MostlyKIGuess/Theremin-Circuit/Report/main.pdf

# Modernizing the Theremin: A Portable Circuit with Single-Antenna and Manual Volume Knob

Krish Pandya
2023102026
IIIT Hyderabad
krish.pandya@students.iiit.ac.in

Vaibhav Wadhwani
2023102058
IIIT Hyderabad
vaibhav.wadhwani@students.iiit.ac.in

Abstract—This report details the design, simulation, and testing of a modernized portable Theremin, an electronic musical instrument played without physical contact. Unlike traditional Theremins, our design features a single antenna for pitch control and a manual potentiometer for volume adjustment, making it more compact and accessible. The circuit utilizes capacitive sensing via the antenna to control the pitch of the output sound, with the core principle involving heterodyning signals from a Variable Frequency Oscillator (VFO) and a Fixed Frequency Oscillator (FFO). The resulting difference frequency, falling within the audible range, is then filtered, amplified, and output through a power amplifier stage. The design primarily uses operational amplifiers for oscillation, mixing, filtering, and preamplification, with a Class AB BJT stage for power amplification. Operating on a ±5V dual power supply derived from batteries, the circuit is completely portable and ready for use in various performance settings.

I. INTRODUCTION

The Theremin, invented by Leon Theremin around 1920, ´ stands as one of the earliest electronic musical instruments and is unique for being played without physical contact. It typically features two antennas: one controlling pitch and the other controlling volume, based on the proximity of the player’s hands [1]. The instrument operates on the principle of heterodyning, where two high-frequency radio signals are mixed together. The difference between these two frequencies results in a beat frequency within the audible range (20 Hz to 20 kHz). Traditional Theremins typically feature two antennas: one controlling pitch and the other controlling volume, based on the proximity of the player’s hands. Our modernized approach simplifies this design by using a single antenna for pitch control and incorporating a manual potentiometer for volume adjustment, making the instrument more portable and user-friendly.
The use of heterodyning is advantageous because LC oscillators, commonly used in such circuits, exhibit greater stability and precision at higher frequencies (hundreds of kHz to MHz range). Generating stable audio-frequency tones directly using simple LC circuits can be challenging and less accurate. By generating two higher frequencies—one fixed (FFO) and one variable (VFO) controlled by hand capacitance—and then mixing them, a precisely controllable audio frequency (fV F O − fF F O) can be obtained. The player’s hand acts as the grounded plate of a variable capacitor relative to the pitch antenna, altering the capacitance in the VFO circuit and thus changing its frequency.
This project focuses on the design, simulation, and implementation of a portable Theremin circuit using readily available components like operational amplifiers (Op-Amps) and bipolar junction transistors (BJTs). While traditional Theremins use a second antenna for volume control, this design employs a potentiometer for manual volume adjustment.

II. WORKING PRINCIPLE
The operation of the designed Theremin circuit relies on several key principles:
- Capacitive Sensing: The player’s hand acts as a variable capacitor when brought near the pitch antenna. This change in capacitance modifies the frequency of the Variable Frequency Oscillator (VFO).
- Oscillation: Two oscillators are used:
– Variable Frequency Oscillator (VFO): Its frequency changes based on the hand’s proximity to the pitch antenna.
– Fixed Frequency Oscillator (FFO): Generates a stable reference frequency close to the VFO’s operating range.
- Heterodyning (Mixing): The signals from the VFO and FFO are combined using a mixer circuit (summing amplifier). The output of the mixer contains sum (fV F O+ fF F O) and difference (|fV F O − fF F O|) frequencies.
- Filtering: Active filters (low-pass and high-pass) are employed to isolate the difference frequency, which constitutes the audible tone, and remove unwanted DC offsets and high-frequency components.
- Amplification and Volume Control: The filtered audio signal is amplified. A potentiometer is integrated to allow manual control over the final output volume before the signal is sent to the power amplifier.
- Power Amplification: A Class AB power amplifier stage provides sufficient current gain to drive a low-impedance load, such as a speaker.

III. CIRCUIT OVERVIEW
The complete Theremin circuit designed and simulated in LTSpice is shown in Fig. 1. It integrates several functional blocks: the VFO, FFO, Mixer, Filters, Pre-Amplifier/Volume

Control, Sound Amplifier, and Power Amplifier. Operational amplifiers (OP27, UA741, OP37) are utilized for most signal generation and processing stages. The circuit is powered by a ±5V dual rail supply, typically derived from batteries using voltage regulators ( Note: We used give power supply, also tested using batteries , so it is completely portable and ready to use). Fig. 2 shows a representation related to the physical implementation.
We have written almost all the formulas that we used in circuit, for further derivations and calculations, please refer to the slides ( Available on Github ) [5] . The circuit is designed to be compact and efficient, with careful consideration of component values to achieve the desired frequency response and gain characteristics. (Note: In the report the numbers you see with R and C, they can be cross-referenced with the circuit diagram, and these values can be seen in the circuit diagram 1, that can also be found on github as it’s LTSpice file as well as images).


Fig. 1: Simulated Theremin Circuit Schematic (LTSpice)

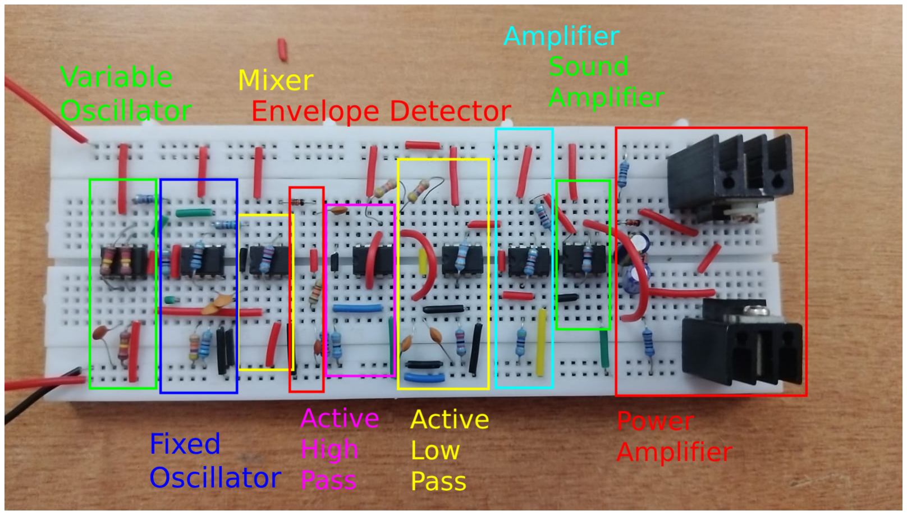
[picture p8: figure]

Fig. | 2: | Theremin | Circuit | Schematic | (Physical
Layout/Simplified)

IV. OSCILLATOR STAGES
A. Variable Frequency Oscillator (VFO)
The VFO generates a signal whose frequency is sensitive to the capacitance of the pitch antenna, which varies with hand proximity.
- Topology: An Op-Amp based relaxation oscillator using U1 (OP27) was chosen [2].
- Key Components: U1 (OP27), R1, R2, R3 (100 kΩ), C1 (100 pF), Antenna (modeled as 23 pF base capacitance + variable hand capacitance Chand) (Note: This can vary , ours was a copper wire around 600cm coiled up , so it came around this from frequency calculation.).
- Operation: The total capacitance (Ctotal = Cbase + Chand) at the oscillator’s timing node determines its frequency. As the hand approaches the antenna, Chand increases, increasing Ctotal and thus decreasing the VFO frequency fV F O. Due to heterodyning, a decrease in fV F O leads to an increase in the difference frequency (|fV F O − fF F O|), resulting in a higher audible pitch.
- Frequency Calculation: The approximate frequency of the relaxation oscillator is given by:

fV F O ≈

1
2RCtotal ln
1+k
1−k
| (1)

where R involves resistors like R3, Ctotal is the total capacitance including the antenna and C1 (specific calculation depends on exact topology implementation, e.g., R=120k, C=175p from slides gives 21.9kHz), and k =

R2
R1+R2

. With R1=R2=100 kΩ, k = 0.5, and ln( ¹⁺⁰.5
1−0.5

) = ln(3) ≈ 1.1. The exact values used in the physical circuit (R = 120k, C = 175p - base capacitance) give a slightly different calculated base frequency around 21.92 kHz.

The output waveform of the implemented variable oscillator is shown in Fig. 3.


Fig. 3: Variable Oscillator Output Waveform (Physical Measurement)

B. Fixed Frequency Oscillator (FFO)

The FFO provides a stable reference frequency against which the VFO is compared.

- Topology: A Wien Bridge Oscillator using U7 (UA741 Op-Amp).
- Key Components: U7 (UA741), R18=6.3 kΩ, C4=1 nF, R19=6.3 kΩ, C6=1 nF (frequency network); R16=47 kΩ, R17=100 kΩ (gain network).
- Operation: | The | Wien | Bridge | network | provides
frequency-selective positive feedback. Oscillation occurs at the frequency where the phase shift is zero and the loop gain is unity.
- Frequency Calculation: The oscillation frequency is determined by:
fF F O = | 1
2πRC =
| | | 1
2π(6.8 kΩ)(1 nF) ≈ 23.26 kHz (2)

The required gain for oscillation is Av = 1+R17/R16 = 1 + 100k/47k ≈ 3.13. The gain provided by the circuit is 1 + R17/R16 = 1 + 100k/47k ≈ 3.13 ensuring oscillation starts.

The output waveform of the implemented fixed oscillator is shown in Fig. 4.


Fig. 4: Fixed Oscillator Output Waveform (Physical Measurement)

V. SIGNAL PROCESSING STAGES
A. Mixer (Summing Amplifier)

The mixer combines the VFO and FFO signals to generate the sum and difference frequencies.
- Topology: An inverting summing amplifier using U2 (OP27).
- Key Components: U2 (OP27), Input Resistors R4=47 kΩ (from VFO), R5=47 kΩ (from FFO), Feedback Resistor R6=20 kΩ.
- Operation: The output voltage is the inverted sum of the input voltages, scaled by the ratio of feedback to input resistance.
- Gain Calculation: The gain for each input is:

G = −

Rf

Rin

= −

20 kΩ
47 kΩ ≈ −0.426 | (3)
- Output Voltage:

Vout,mixer = G×(VV F O+VF F O) = −0.426(VV F O+VF F O)
| (4)
This output contains components at frequencies fV F O, fF F O, fV F O + fF F O, and |fV F O − fF F O|.
B. Envelope Detector

An envelope detector stage is included after the mixer. In traditional Theremins, envelope detection might relate to volume control coming from the second antenna. However, in our design, it is used to demodulate the mixed signal.
- Components: Diode D (1N4148), R7 (10 kΩ), C2 (47 nF).
- Function: Performs half-wave rectification (via Diode D) followed by RC low-pass filtering (R7, C2) to extract the signal envelope [3]. This stage seems intended to demodulate the mixed signal to some extent, although its placement after the summing mixer is unconventional for isolating the beat frequency directly.
- Time Constant: τ = R7 × C2 = (10 kΩ)(47 nF) = 0.47 ms.
- Cutoff Frequency: The RC filter has a cutoff frequency fc =

1
2πτ ≈

1
2π(0.47 ms) ≈ 339 Hz. This low cutoff will primarily passes the lower frequency components, including the beat frequency, while smoothing the waveform. ( Note: Explained more in the youtube video [4] )
The output after the envelope detector stage is shown in Fig. 5.
C. Active Filtering Stages

Subsequent filtering stages refine the audio signal.
1) Active High-Pass Filter (HPF): This filter removes any DC offset introduced by previous stages (like the envelope detector) and very low frequencies.
- Topology: First-order active HPF using U3 (OP27) configured as a buffer.
- Components: U3 (OP27), C5 (4.7 nF), R13 (1.7 MΩ).


Fig. 5: Envelope Detector Output Waveform (Physical Measurement)

- Cutoff Frequency:

fc,HP F =

1
2πR13C5

=

1
2π(1.7 MΩ)(4.7 nF) ≈ 19.9 Hz

(5)
This cutoff is appropriate for passing the audible range while blocking DC.

The output after the high-pass filter stage is shown in Fig. 6.
2) Active Low-Pass Filter (LPF): This filter removes high-frequency components remaining after mixing and envelope detection, such as sums of frequencies or oscillator harmonics, leaving primarily the desired difference frequency.
- Topology: Second-order active LPF using U5 (OP27), likely a Sallen-Key or Multiple Feedback topology providing gain. Based on components R10, R11, R12, C3, R23, C9, it resembles a design with feedback providing amplification.
- Components: U5 (OP27), R10=6.3 kΩ, C3=10 nF,
R23=6.3 kΩ, | C9=10 nF | (frequency | determining);
R11=40 kΩ, R12=20 kΩ (gain setting).
- Cutoff Frequency Estimation: For a Sallen-Key LPF with equal R (R10=R23) and C (C3=C9), fc =
| | | 1 2πRC .
Using R=6.3 kΩ and C=10 nF:

fc,LP F =

1
2π(6.3 kΩ)(10 nF) ≈ 2.53 kHz (6)
- DC Gain: The gain appears set by R11 and R12 in a non-inverting configuration related to the feedback:

GDC = 1 +

R11
R12

= 1 +

40 kΩ
20 kΩ = 3 | (7)


Fig. 6: High-Pass Filter Output Waveform (Physical Measurement)

This stage both filters and amplifies the audio signal.

VI. AMPLIFICATION STAGES

A. Pre-Amplifier / Volume Control

This stage provides further voltage gain and incorporates the user volume control.
- Topology: Non-inverting amplifier using U6 (OP27) with gain adjusted by potentiometer U9.
- Components: U6 (OP27), R14 (20 kΩ), R15 (5 kΩ), U9 (Potentiometer, 10 kΩ).
- Gain Range: The voltage gain Av varies with the potentiometer setting (RU9 represents the resistance from the wiper to ground):

Av = 1 +

R14
R15 + RU9

(8)

– Minimum Gain (RU9 = 10 kΩ): Av = 1 + 20
5+10 =
1 + 20
15 ≈ 2.33
– Maximum Gain (RU9 = 0 kΩ): Av = 1 + 20
5+0 =
1 + 4 = 5
B. Sound Amplifier

An additional amplifier stage boosts the signal level before the power amplifier.
- Topology: Inverting amplifier configuration using U4 (OP37).
- Components: U4 (OP37), R8 (10 kΩ), R9 (40 kΩ).
- Gain:
G = −

R9
R8

= −

40 kΩ
10 kΩ = −4 | (9)

This stage inverts the signal while providing a gain of 4.

VII. POWER AMPLIFIER STAGE

The final stage provides the necessary current to drive a low-impedance load like a speaker.
- Topology: Class AB Push-Pull output stage using complementary BJT pair.
- Key Components: Q1 (TIP31C NPN BJT), Q2 (TIP32C PNP BJT), D1, D2 (1N4148 diodes for bias), R20, R21 (1 kΩ base resistors), C7, C8 (1 µF bypass capacitors), R22 (10 Ω load resistor).
- Operation: Q1 amplifies the positive half-cycles of the input signal, while Q2 amplifies the negative half-cycles. Diodes D1 and D2 provide a small forward bias voltage between the bases of Q1 and Q2 to minimize crossover distortion, ensuring a smoother transition between the transistors conducting. This stage primarily provides current gain (power gain) with approximately unity voltage gain.

VIII. POWER SUPPLY

The circuit requires a stable dual-rail power supply for the operational amplifiers and other stages.
- Requirement: ± 5 V DC.
- Implementation: Typically achieved using two 9V batteries connected in series with the center tap serving as ground. Voltage regulators LM7805 (for +5V) and LM7905 (for -5V) are used to provide stable regulated voltages from the batteries.
- Consumption: The Op-Amps consume relatively low quiescent current. The power amplifier stage draws more current depending on the output volume and load. The total power consumption is estimated to be under 3W under normal operation.

IX. OPERATION AND RESULTS

The integrated Theremin circuit functions as follows: The player’s hand proximity to the antenna (modeled by CAntenna) controls the frequency of the VFO (U1). This signal is mixed (U2) with the stable frequency from the FFO (U7). The resulting mixed signal undergoes envelope detection (D, R7, C2) and active filtering (U3, U5) to isolate and clean up the audible difference frequency (|fV F O − fF F O|). This audio signal is then amplified (U6, U4), with volume controlled by the potentiometer (U9), and finally fed to the Class AB power amplifier (Q1, Q2) to drive the speaker (R22).
Physical measurements (Fig. 3, 4, 5, 6) confirm the operation of individual stages, showing the expected waveforms at the outputs of the oscillators, envelope detector, and high-pass filter. The variable oscillator frequency changes as intended with capacitance, and the fixed oscillator provides a stable reference. The filtering stages shape the signal towards the final audio output. The overall result is an audible tone whose pitch changes with hand movement near the antenna and whose volume is adjustable via the potentiometer.
X. PROJECT DEMONSTRATION
A video demonstration showcasing the operation of the constructed Theremin circuit is available online [4]. The video explains the working principles, shows the physical circuit build, and demonstrates the pitch control via hand proximity to the antenna and volume control using the potentiometer.

XI. CONCLUSION
This project successfully demonstrated the design, simulation, and testing of an electronic Theremin circuit based on operational amplifiers and a BJT Class AB output stage. The design employs the principle of heterodyning by mixing signals from a hand-capacitance controlled Variable Frequency Oscillator and a Fixed Frequency Oscillator (Wien Bridge type). The resulting difference frequency is extracted using an envelope detector and active filtering stages (high-pass and low-pass) to produce an audible tone within the range of approximately 20 Hz to 2.5 kHz (based on filter cutoffs). Volume control is implemented manually via a potentiometer integrated into a pre-amplifier stage. A final Class AB power amplifier provides sufficient power to drive a standard 10 Ω speaker load. The circuit operates from a standard ±5 V regulated dual power supply. The design choices, particularly the use of an envelope detector post-mixing and potentiometerbased volume control, differ from some traditional Theremin architectures but provide a functional implementation of the core concept. The simulation and physical measurements validate the operation of the individual stages and the overall system.

REFERENCES

[1] Wikipedia contributors, ”Theremin,” Wikipedia, The Free Encyclopedia, https://en.wikipedia.org/wiki/Theremin .
[2] Circuit | Digest, | ”Relaxation | Oscillator | using | Op-Amp,”
https://circuitdigest.com/tutorial/relaxation-oscillator-using-op-amp
[3] C. Rose, ”Envelope Detector,” Rutgers WINLAB, https://www.winlab.rutgers.edu/∼crose/322 html/envelope detector.html (https://www.winlab.rutgers.edu/~crose/322_html/envelope_detector.html) .
[4] K. Pandya and V. Wadhwani, ”Theremin Project Explanation and Demo,” YouTube, May 5, 2025. [Online]. Available: https://youtu.be/XMQbpG15ijk?si=fTLJ23zKhtOCA8q9 (https://youtu.be/XMQbpG15ijk?si=fTLJ23zKhtOCA8q9)
[5] K. Pandya and V. Wadhwani, ”Theremin Project GitHub Repository,” https://github.com/MostlyKIGuess/theremin-circuit .
