MostlyKIGuess/Theremin-Circuit/proposal/main.pdf

# EW-2 Project 2 Proposal Theremin

### Krish Pandya krish.pandya@students.iiit.ac.in

2023102026

### Vaibhav Wadhwani vaibhav.wadhwani@students.iiit.ac.in

2023102058

### 4th February 2025

## 1 Project Proposal

This project proposes the design and construction of a modern Theremin, a touchless electronic musical instrument that merges classic analog circuitry with contemporary design techniques. The instrument will convert subtle human gestures into continuously variable musical tones by utilizing oscillator and amplifier circuits. The primary objectives of the project are as follows:
1. To develop reliable oscillator circuits using CMOS logic and analog components that generate controllable waveforms.
2. To employ the LM386 audio amplifier for clear and effective sound amplification.
3. To implement a responsive control mechanism that accurately translates hand movements into frequency variations.
4. To evaluate the system performance in terms of sound quality, responsiveness, and overall stability.
This project not only applies fundamental principles of electronic circuit design but also explores innovative methods of human-machine interaction.

## 2 Working Principle of a Theremin

A Theremin operates using two key principles: capacitance variation and heterodyning. The instrument typically features two antennas; one controls pitch and the other controls volume. The pitch antenna is connected to a high-frequency oscillator. When a performer moves their hand near the antenna, the capacitance in the oscillator circuit changes, altering the frequency slightly. This frequency-modulated signal is then mixed with a fixed reference frequency in a process known as heterodyning, producing an audible beat frequency that changes according to hand movement. The volume antenna, in contrast, modulates the amplitude of the output signal by sensing proximity, allowing for dynamic control of the loudness. Together, these mechanisms allow the performer to manipulate both pitch and volume without physical contact, creating a unique and expressive instrument.

## 3 Project Requirements


Figure 1: Theremin Schematic

The following list details the critical components required for the project:

### Integrated Circuits

- CMOS CD4069UBE hex inverter (3 units): Used for signal inversion and waveform generation in the oscillator sections.
- LM386 audio amplifier (1 unit): Amplifies the generated audio signal to drive a speaker efficiently.

### Resistors

- 10 Ohm resistor (1 unit)
- 27 kOhm resistor (5 units)
- 22 kOhm resistor (3 units)
- 270 kOhm resistor (4 units)
- 470 kOhm resistor (1 unit)
- 1 kOhm variable resistor (1 unit)
- 10 kOhm variable resistor (2 units)

### Capacitors

- 100 pF capacitor (3 units)
- 0.01 µF capacitor (2 units)
- 0.1 µF capacitor (2 units)
- 10 µF capacitor (2 units)
- 1000 µF capacitor (1 unit)
- 1 nF variable capacitor (1 unit)

### Other Electronics

- Diodes (2 units): Provide circuit protection and assist in signal rectification.
- Slide Switch (e.g., SS22D18) (1 unit): Facilitates power control or mode selection within the circuit.
- Speaker (e.g., 0.2 W, 8 Ohm breadboard mount speaker) (1 unit): Outputs the amplified audio signal.
- 5V Power Supply (1 or 2 units): Ensures a stable operating voltage for the entire circuit.

## 4 Conclusion

The proposed Theremin project ties together essential electronic principles with a musical application. By leveraging both standard and variable components, the instrument will respond to user gestures, offering a unique interface and auditory experience.
