MostlyKIGuess/Theremin-Circuit/Slides/main.pdf

## Theremin Design and Simulation

Krish Pandya (2023102026) Vaibhav Wadhwani (2023102058)

IIITH

Theremin | 1 / 20

Outline 1 | Introduction 2 | Working Principles 3 | Circuit Overview 4 | Physical Circuit Overview 5 | Variable Oscillator (Pitch Control) 6 | Fixed Oscillator (Reference) 7 | Mixer (Summing Amplifier) 8 | Filtering Stages 9 | Envelope Detector Output

10 High Pass Output

11 Amplifier Stages

12 Power Amplifier
13 Power Supply

14 Conclusion

## Introduction to Theremin

An electronic musical instrument played without physical contact.
Invented by L´eon Theremin around 1920.
Uses two antennas to control pitch and volume based on hand proximity. Operates on the principle of heterodyning: mixing two high-frequency signals to produce an audible difference frequency.
Why heterodyning instead of generating audio directly?
LC oscillators are more stable and precise at higher frequencies (100s of kHz to MHz).
Producing stable low-frequency (20 Hz–20 kHz) tones directly with LC circuits is inefficient and inaccurate.
Heterodyning down to audio gives better control and tunability.
The player’s hands act as the grounded plates of variable capacitors, influencing the frequency of oscillators.

## Working Principle of a Theremin

Capacitive Sensing: The player’s hands near the antennas alter the capacitance in oscillator circuits.
Oscillators:
Variable Frequency Oscillator (VFO): Frequency changes based on hand distance from the pitch antenna.
Fixed Frequency Oscillator (FFO): Generates a constant reference frequency. Heterodyning (Mixing): The VFO and FFO signals are combined (mixed). The output contains sum and difference frequencies.
Filtering: Low-pass filtering isolates the difference frequency (fVFO − fFFO), which falls within the audible range.
Volume Control: Typically uses a separate oscillator circuit affected by the volume antenna to control the final output amplitude. We are using a different approach. Potentiometer ( Standard Volume Knobs)

## Circuit Overview


Figure: Simulated Theremin Circuit Schematic (LTSpice)

The circuit consists of several stages: Variable Oscillator, Fixed Oscillator, Mixer/Summer, Filters, Amplifiers, and Power Amplifier.
Operational Amplifiers (Op-Amps) like OP27, UA741, OP37 are used extensively.

## Physical Circuit Overview


Figure: Theremin Circuit Schematic (Physical)

## Variable Oscillator (Pitch Control)

Function: Generates a frequency signal that changes based on hand capacitance near the ’Antenna’.
Topology: Op-Amp based oscillator (OP27). Likely a relaxation type oscillator. Reference (https://circuitdigest.com/tutorial/relaxation-oscillator-using-op-amp)
Key Components:
U1: OP27 Op-Amp
R1, R2, R3: 100 kΩ resistors (biasing and feedback)
C1: 100 pF capacitor
Antenna: 23 pF capacitor (base capacitance, hand adds variable capacitance in parallel)
Operation: The total capacitance at the input influences the oscillation frequency. As the hand moves closer, capacitance increases, typically lowering the frequency.
Note: You will hear high frequency oscillation when hand is getting closer because of the heterodyning effect. As this frequency decreases , the difference in frequencies increases and you will hear a high pitch sound. Calculation:

Oscillation Frequency (fo ):

fo =

1
2RCln ¹⁺k
1−k

≈

1
2(120k)(175p) · ln(3) ≈ 21.92 kHz

wherek =

R2
R1 + R2

Total Capacitance (Ctotal ):

Ctotal = Cbase + Chand = 60p + Chand

As Chand increases, fo decreases.

Capacitance Change:

Chand =

Cbase
(1 −

fo
fmax

)

− Cbase

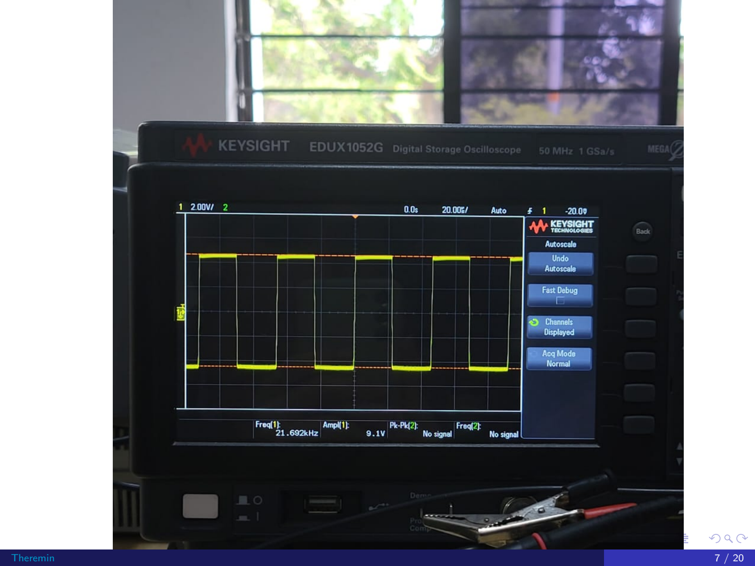
[picture p9: page 9]

## Fixed Oscillator (Reference)

Function: Generates a stable reference frequency for heterodyning. Topology: Wien Bridge Oscillator using U7 (UA741 Op-Amp).
Key Components:
U7: UA741 Op-Amp
Frequency Determining Network: R18=6.3 kΩ, C4=1 nF, R19=6.3 kΩ, C6=1 nF
Gain Setting Network: R16=47 kΩ, R17=100 kΩ

## Fixed Oscillator (Reference) - Calculations

Calculation:
Oscillation Frequency (fo ):

fo =

1
2πRC ≈ 23.26 kHz

Required Gain (Av ): Av ≈ 2.13

## Fixed Oscillator (Reference) - Output

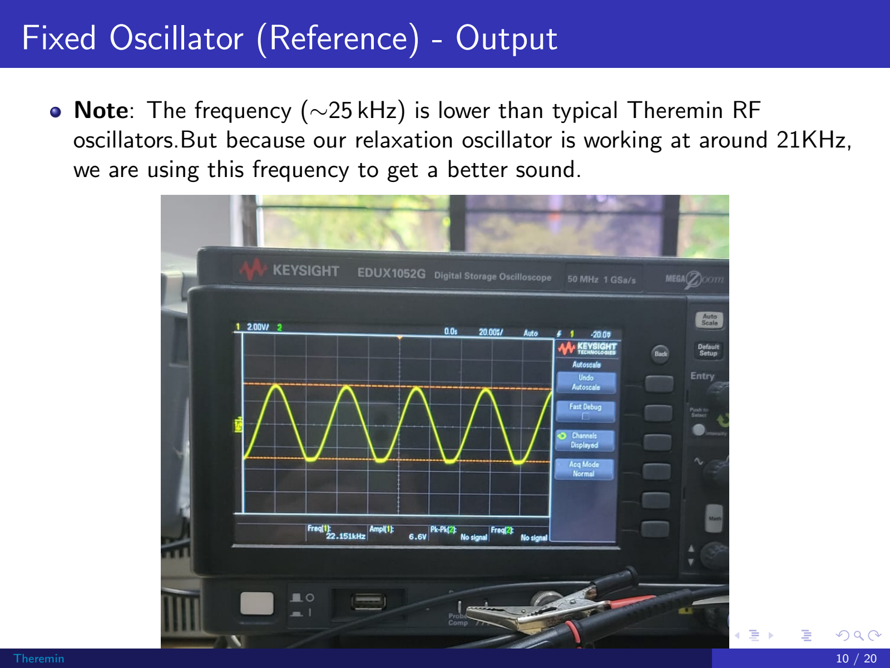
[picture p10: page 12]

Note: The frequency (∼25 kHz) is lower than typical Theremin RF oscillators.But because our relaxation oscillator is working at around 21KHz, we are using this frequency to get a better sound.

## Mixer (Summing Amplifier)

Function: Combines the signals from the Variable and Fixed Oscillators. Topology: Inverting Summing Amplifier using U2 (OP27).
Key Components:
U2: OP27 Op-Amp
Input Resistors: R4=47 kΩ (from Variable Osc.), R5=47 kΩ (from Fixed Osc.) Feedback Resistor: R6=20 kΩ
Calculation:
Gain for each input: G = −

Rf
Rin

≈ −0.426
Output Voltage: Vout = −0.426 × (VVarOsc + VFixedOsc )

## Envelope Detector

Components: Diode D (1N4148), R7 (10 kΩ), C2 (47 nF)
Function: Half-wave rectification followed by RC low-pass filtering. Extracts the envelope of the signal from the mixer. Reference (https://www.winlab.rutgers.edu/~crose/322_html/envelope_detector.html)
Time Constant: τ = R7 × C2 = 0.47 ms
Cutoff Freq.: fc ≈ 1/(2πτ ) ≈ 339 Hz
Note: Placement after mixer is unconventional for standard Theremin volume control. And is intentional design choice to suppress the DC offset created by the envelope detector.

## Envelope Detector Output

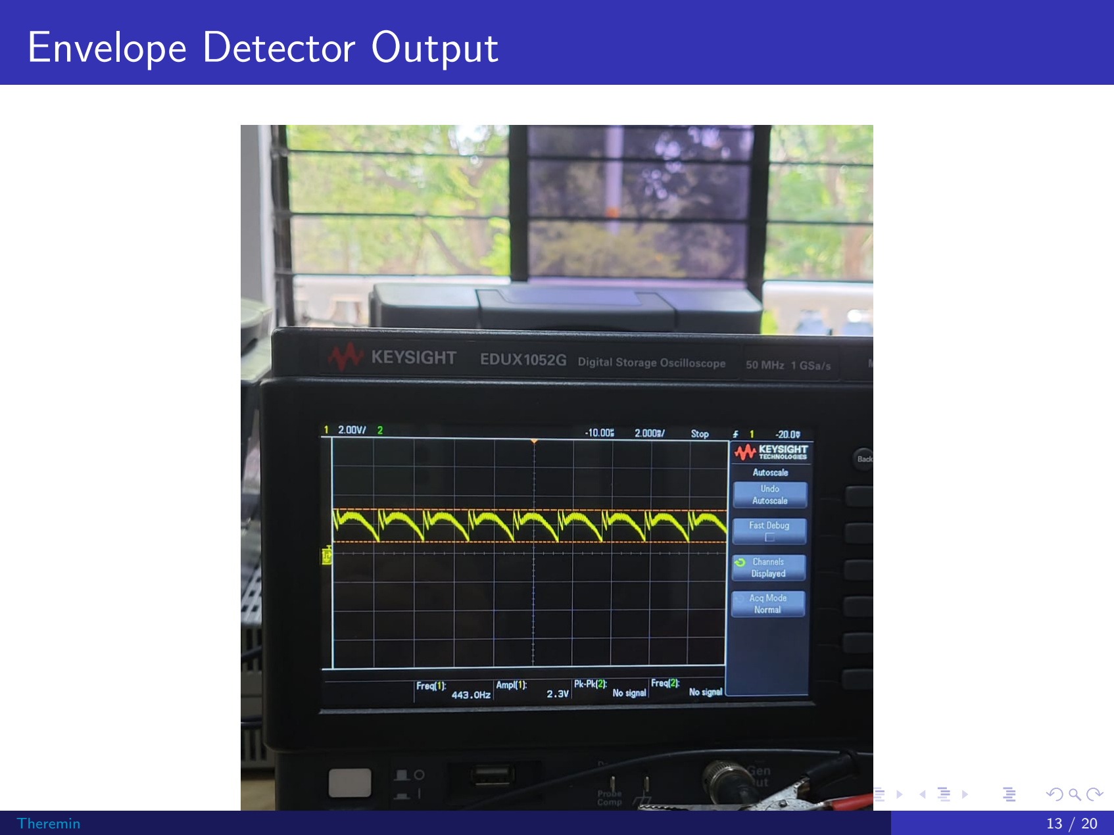
[picture p11: page 15]

## Active Filters

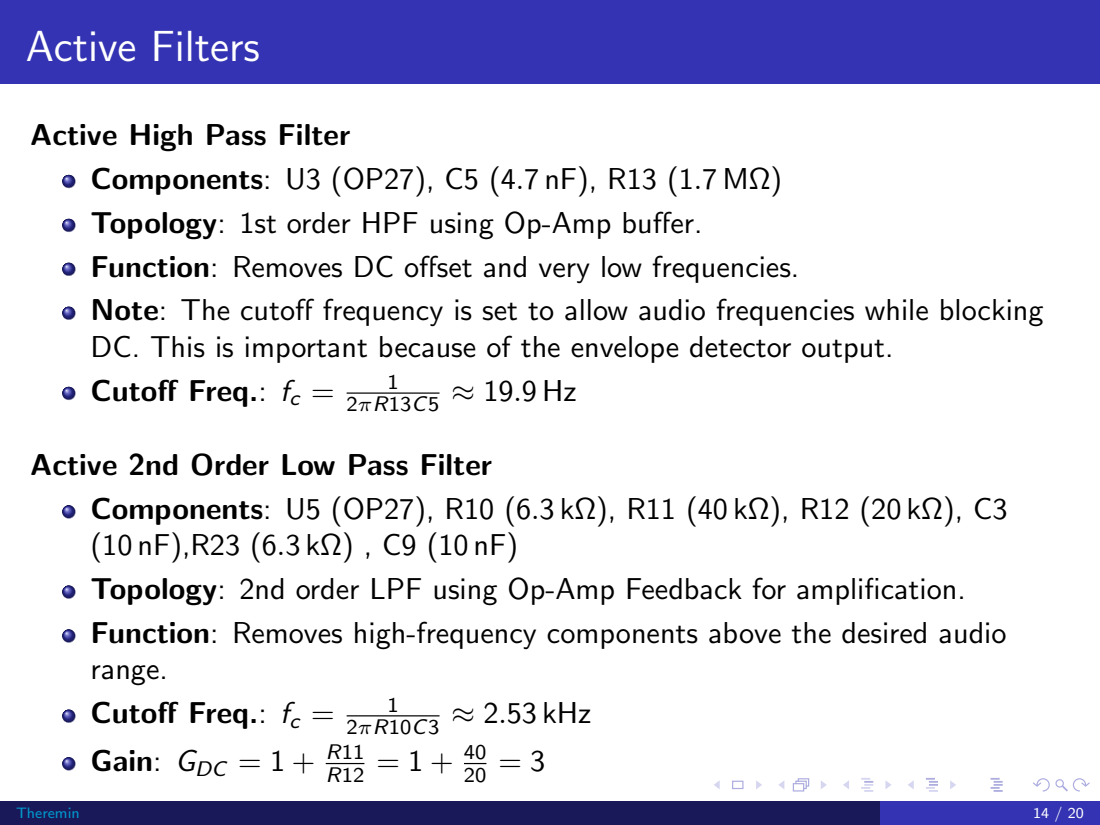
[picture p12: page 16]

Active High Pass Filter
Components: U3 (OP27), C5 (4.7 nF), R13 (1.7 MΩ)
Topology: 1st order HPF using Op-Amp buffer.
Function: Removes DC offset and very low frequencies.
Note: The cutoff frequency is set to allow audio frequencies while blocking
DC. This is important because of the envelope detector output.
Cutoff Freq.: fc =

Active 2nd Order Low Pass Filter
Components: U5 (OP27), R10 (6.3 kΩ), R11 (40 kΩ), R12 (20 kΩ), C3
Topology: 2nd order LPF using Op-Amp Feedback for amplification.
Function: Removes high-frequency components above the desired audio
range.
Gain: GDC = 1 + R11

## High Pass Output

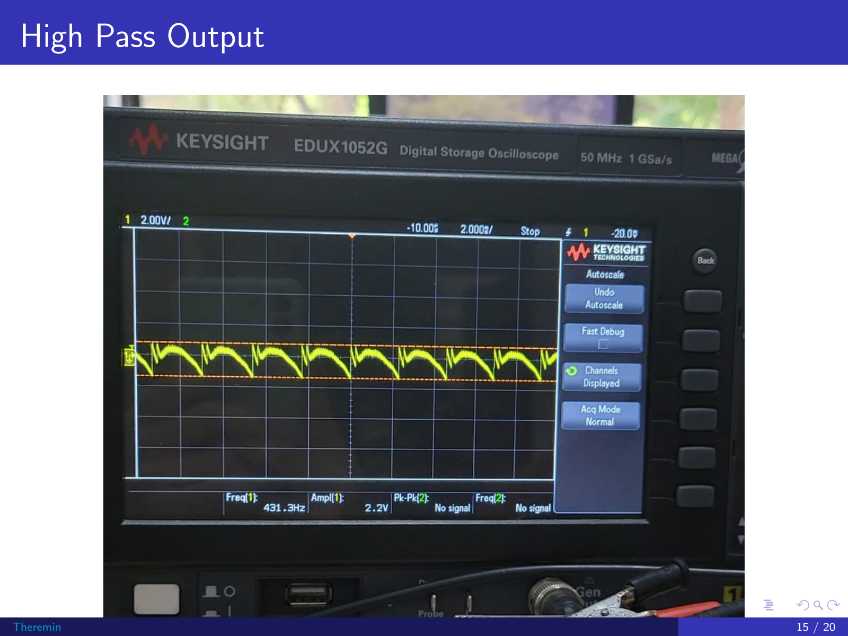
[picture p13: page 17]

## Pre-Amplifier / Volume Control

Components: U6 (OP27), R14 (20 kΩ), R15 (5 kΩ), U9 (Potentiometer, 10 kΩ)
Topology: Non-inverting amplifier with adjustable gain via potentiometer U9.
Function: Amplifies the filtered audio signal and provides user volume control.
Gain Range: Av = 1 + R14 R15+RU9

Min Gain (U9=10 kΩ): Av = 2.33 Max Gain (U9=0 kΩ): Av = 5

Sound Amplifier
Components: U4 (OP37), R9 (40 kΩ), R8 (10 kΩ),
Topology: Sound amplifier using OP37.
Function: Further amplifies the audio signal to drive the power amplifier. Gain: G = −

R9
R8 = −4

## Power Amplifier

Function: Boosts the signal power to drive a low-impedance load like a speaker (R22).
Topology: Class AB Push-Pull Output Stage.
Key Components:
Q1: TIP31C (NPN BJT)
Q2: TIP32C (PNP BJT Complementary Pair)
D1, D2: 1N4148 diodes for biasing (reduce crossover distortion) R20, R21: 1 kΩ base current limiting/biasing resistors
C7, C8: 1 µF bypass/filtering capacitors
R22: 10 Ω Load Resistor (representing speaker)
Operation: Q1 conducts for positive signal swings, Q2 conducts for negative swings. Diodes provide a small forward bias to minimize the ”dead zone” near zero crossings.

## Power Supply Requirements

Dual Rail Supply:
Voltage: ±5 V DC (V1 and V2) Current: 10 mA to 100 mA
Battery Implementation:
Two 9V batteries connected in series Center tap connection between batteries Voltage regulation:
LM7805 for +5V regulation
LM7905 for -5V regulation
Power Consumption:
Op-Amps: Low power consumption BJT stages: Moderate current draw Total power typically under 3 W

## Conclusion

A Theremin circuit based on Op-Amps and a BJT push-pull stage was designed and simulated and tested.
Key stages: Variable Oscillator, Fixed Wien Bridge Oscillator, Summing Amplifier, Active Filters, Volume Control Pre-Amp, Buffer, and Class AB Power Amplifier.
The design utilizes heterodyning, capacitive sensing, filtering, and amplification principles.
Component values and calculated parameters were determined from the schematic.
Operates on ±5 V power rails.
Our design choices differ from traditional Theremin designs, particularly in the volume control stage.

## Thank You

## Thank you for your attention!

## Questions?
