MostlyKIGuess/Theremin-Circuit/Report/circuit.png

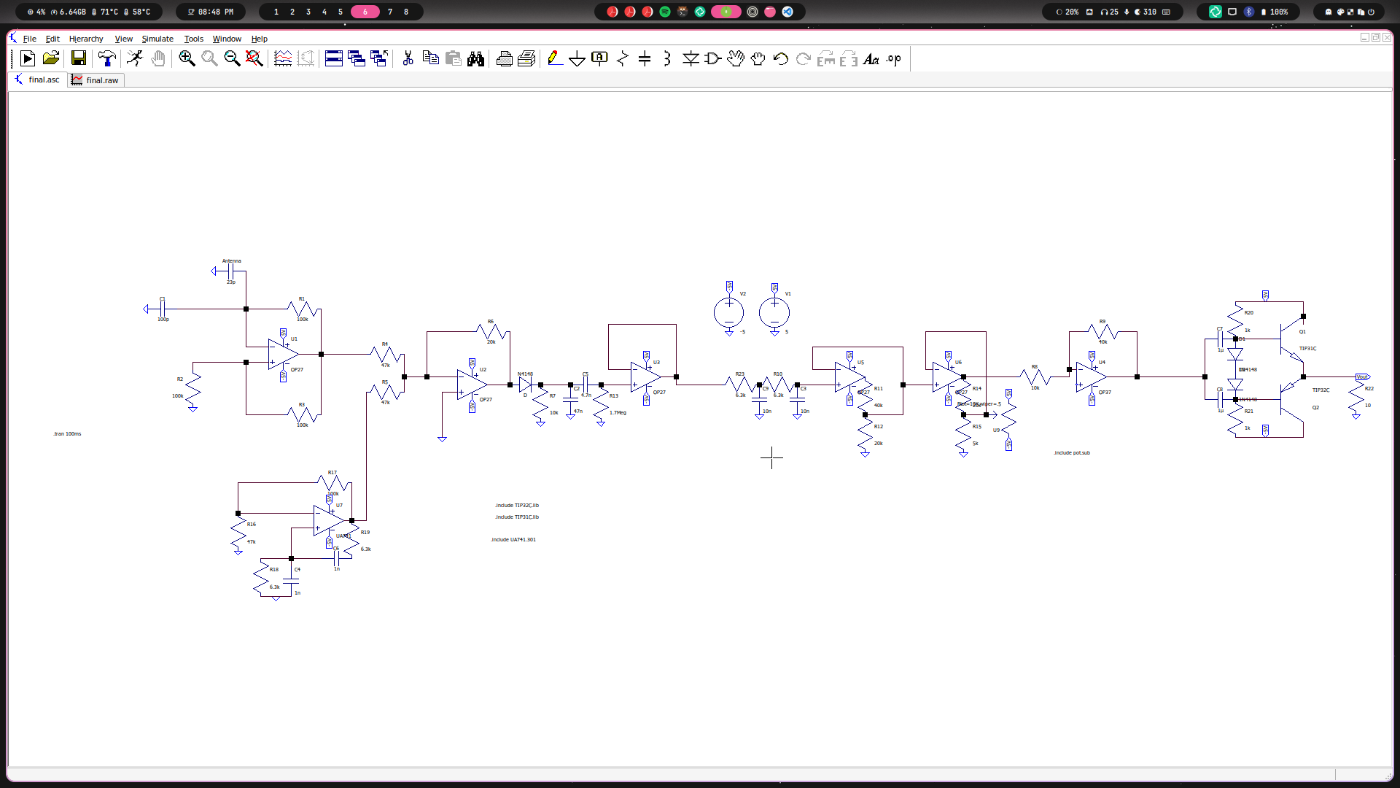
Report/circuit.png
