MostlyKIGuess/Theremin-Circuit/Report/final_output.png

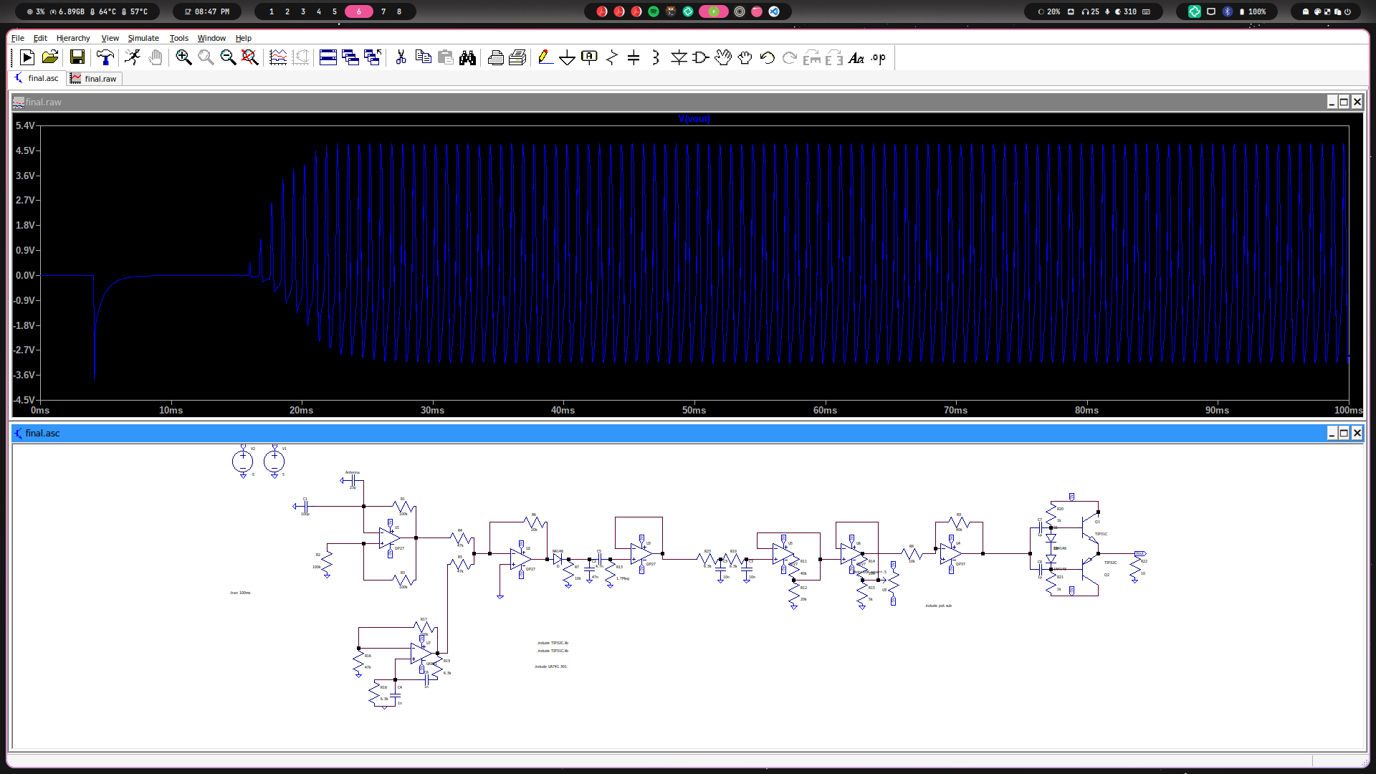
Report/final_output.png
