MostlyKIGuess/Theremin-Circuit/Report/mixeroutput.jpeg

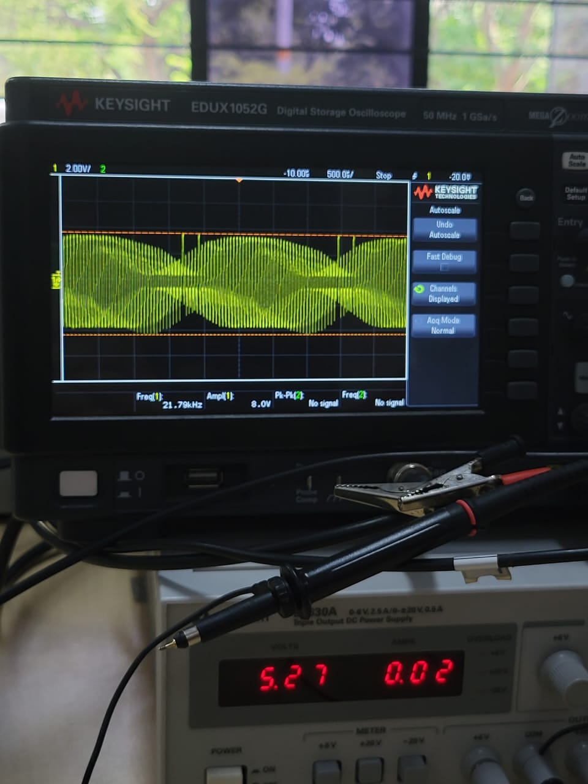
Report/mixeroutput.jpeg
