MostlyKIGuess/Theremin-Circuit/final.asc

Antenna: cap; 23p
C1: cap; 100p
C2: cap; 47n
C3: cap; 10n
C4: cap; 1n
C5: cap; 4.7n
C6: cap; 1n
C7: cap; 1µ
C8: cap; 1µ
C9: cap; 10n
D1: diode; 1N4148
D2: diode; 1N4148
N4148: diode
Q1: npn; TIP31C
Q2: pnp; TIP32C
R1: res; 100k
R2: res; 100k
R3: res; 100k
R4: res; 47k
R5: res; 47k
R6: res; 20k
R7: res; 10k
R8: res; 10k
R9: res; 40k
R10: res; 6.3k
R11: res; 40k
R12: res; 20k
R13: res; 1.7Meg
R14: res; 20k
R15: res; 5k
R16: res; 47k
R17: res; 100k
R18: res; 6.3k
R19: res; 6.3k
R20: res; 1k
R21: res; 1k
R22: res; 10
R23: res; 6.3k
U1: OP27
U2: OP27
U3: OP27
U4: OP37
U5: OP27
U6: OP27
U7: opamp2; UA741
U9: pot
V1: voltage; 5
V2: voltage; -5
Named nets: 0, 5V, -5V, Vout
.tran 100ms
.include UA741.301
.include TIP31C.lib
.include TIP32C.lib
.include pot.sub
