MostlyKIGuess/Theremin-Circuit/initial.asc

Antenna: cap; 23p
C1: cap; 100p
C2: cap; 47n
C3: cap; 63n
C5: cap; 4.7n
N4148: diode
R1: res; 100k
R2: res; 100k
R3: res; 100k
R4: res; 47k
R5: res; 47k
R6: res; 20k
R7: res; 10k
R8: res; 10k
R9: res; 40k
R10: res; 10k
R11: res; 40k
R12: res; 20k
R13: res; 1.7Meg
R14: res; 20k
R15: res; 5k
U1: OP27
U2: OP27
U3: OP27
U4: OP37
U5: OP27
U6: OP27
V1: voltage; 5
V2: voltage; -5
V3: voltage; SINE(0 5 40k)
Named nets: 0, 5V, -5V, Vout
.tran 100ms
.wave "output.wav" 16 44.1k V(Vout)
