MostlyKIGuess/Theremin-Circuit/(commit log)

2025-03-11 Initial Circuit
2025-03-11 improved mixer , used audio amp on final stage
2025-04-17 Final Circuit along with Libraries
2025-04-20 Slides and Final Circuit Added
